acksen/SafewaterHardware/docs/installation_and_faults_overview/Aquaductor-Controller-Fascia-Overview-08.pdf

T2

# Aquaductor Ultraviolet Water Purification Controller

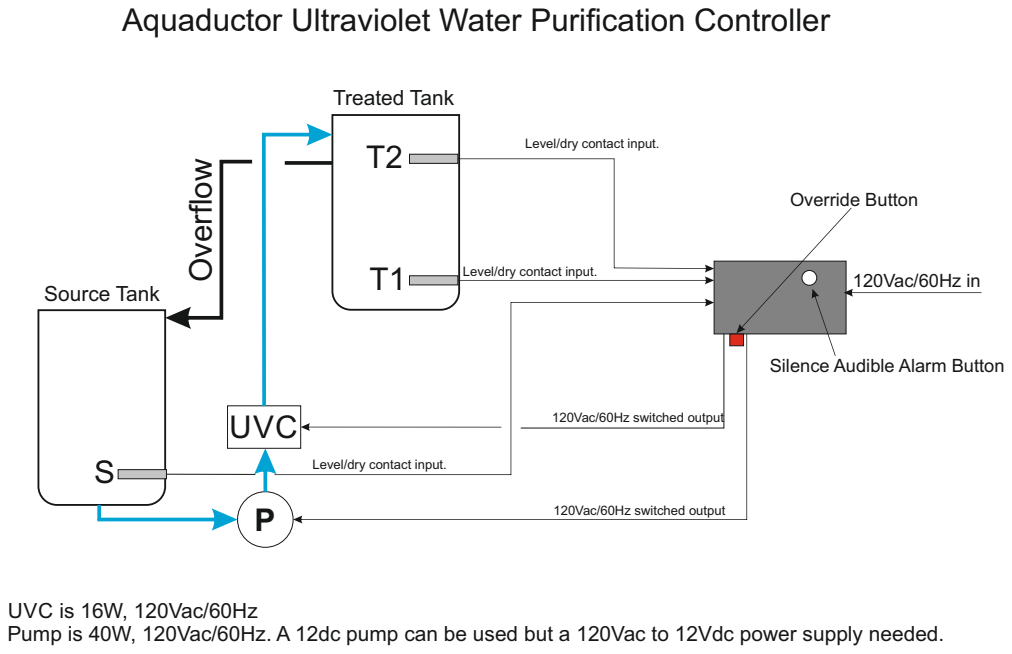
[picture p1: page 1]
UVC; Override Button; 120Vac/60Hz switched output; 120Vac/60Hz in; Source Tank; Treated Tank; Overflow

Level/dry contact input.

Silence Audible Alarm Button

UVC is 16W, 120Vac/60Hz
Pump is 40W, 120Vac/60Hz. A 12dc pump can be used but a 120Vac to 12Vdc power supply needed.

# Motor Pump Motor Pump

# This orientation may be permissible but why would you choose it?

# Recommended pump mounting

# Any leaks run off the pump and cause

minimal risk to the motor and wiring.

# Aquaductor Provisional Enclosure Layout (Scale 1:1 approx)

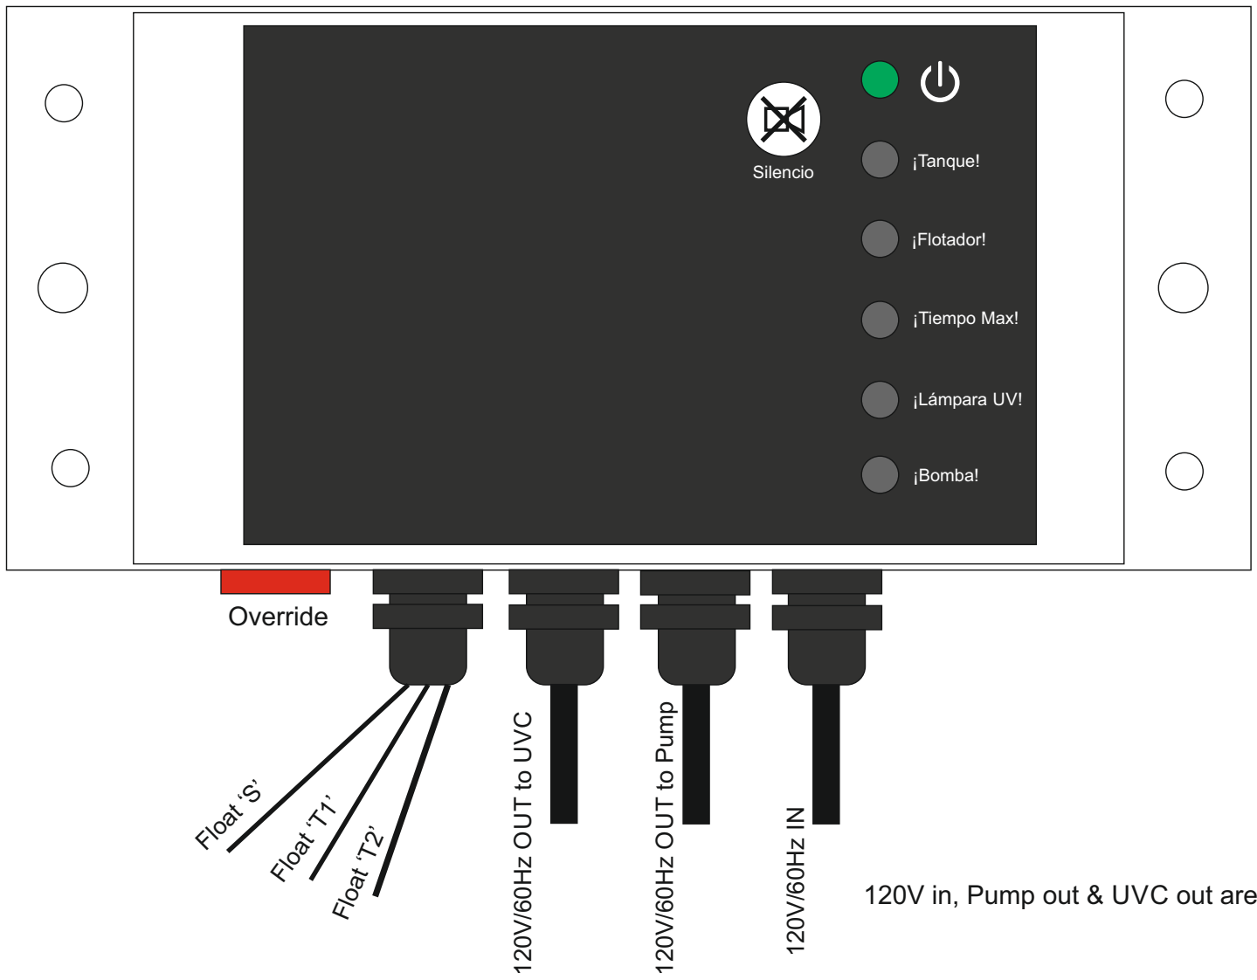
[picture p2: figure]
¡Lámpara UV!; ¡Bomba!; ¡Tiempo Max!; ¡Flotador!; ¡Tanque! Silencio120V/60Hz IN; 120V/60Hz OUT to UVC; 120V/60Hz OUT to Pump; Float ‘S’ Float ‘T1’; Float ‘T2’; Override

120V in, Pump out & UVC out are 1m length leads.

The bottom of this enclosure arrangement MUST be mounted above the highest part of the water circuit, all cables must have drip loops. No part of the water circuit must be mounted above this control enclosure.

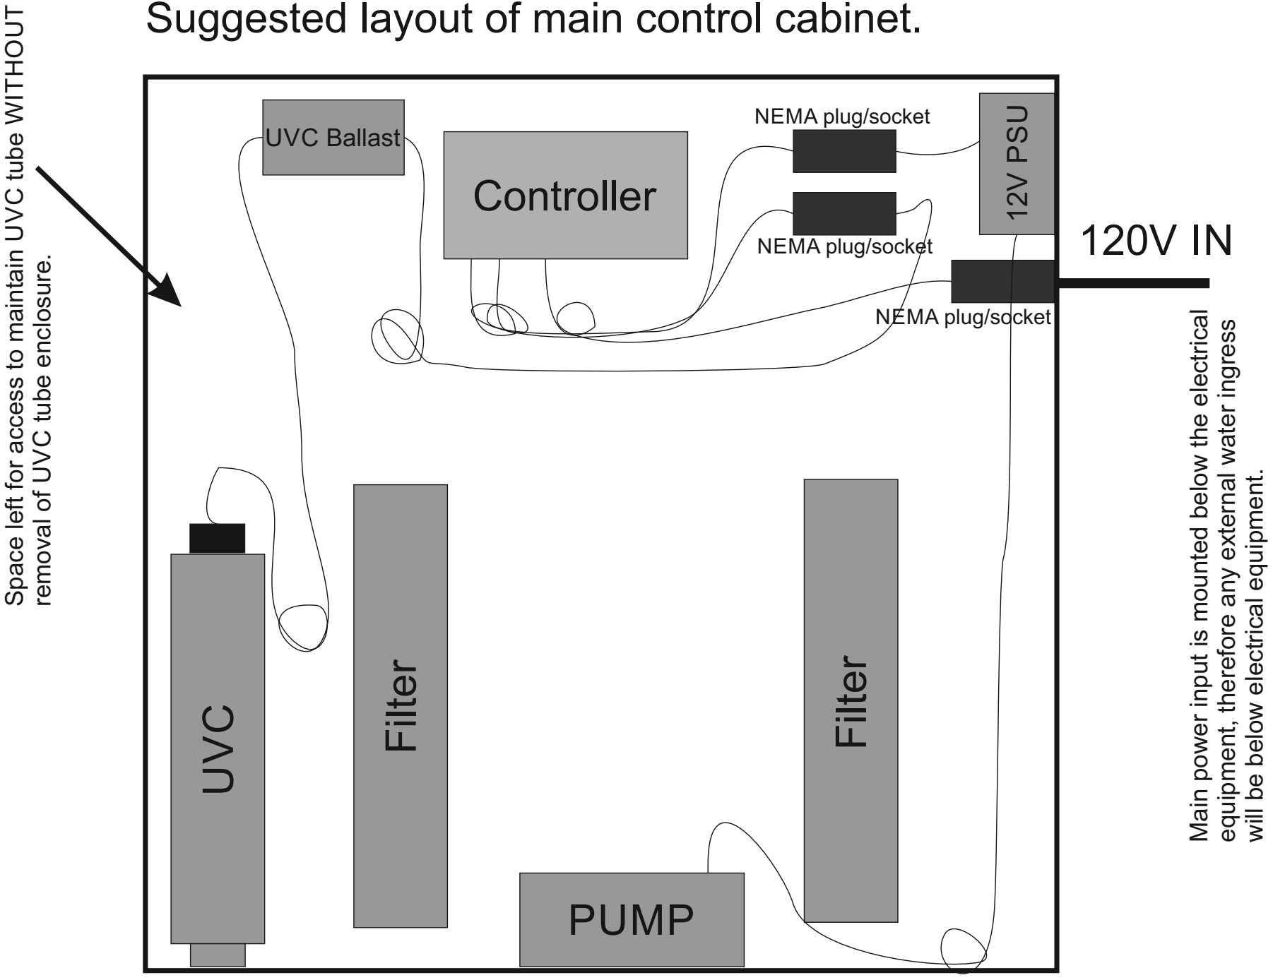
[picture p3: figure]
PUMP; Filter; Space left for access to maintain; C tube; WIT; removal of; C tube enclosure.; UVC Ballast; Controller; NEMA plug/socket; will be below electrical equipment.

Suggested layout of main control cabinet.

Main power input is mounted below the electrical
equipment, therefore any external water ingress

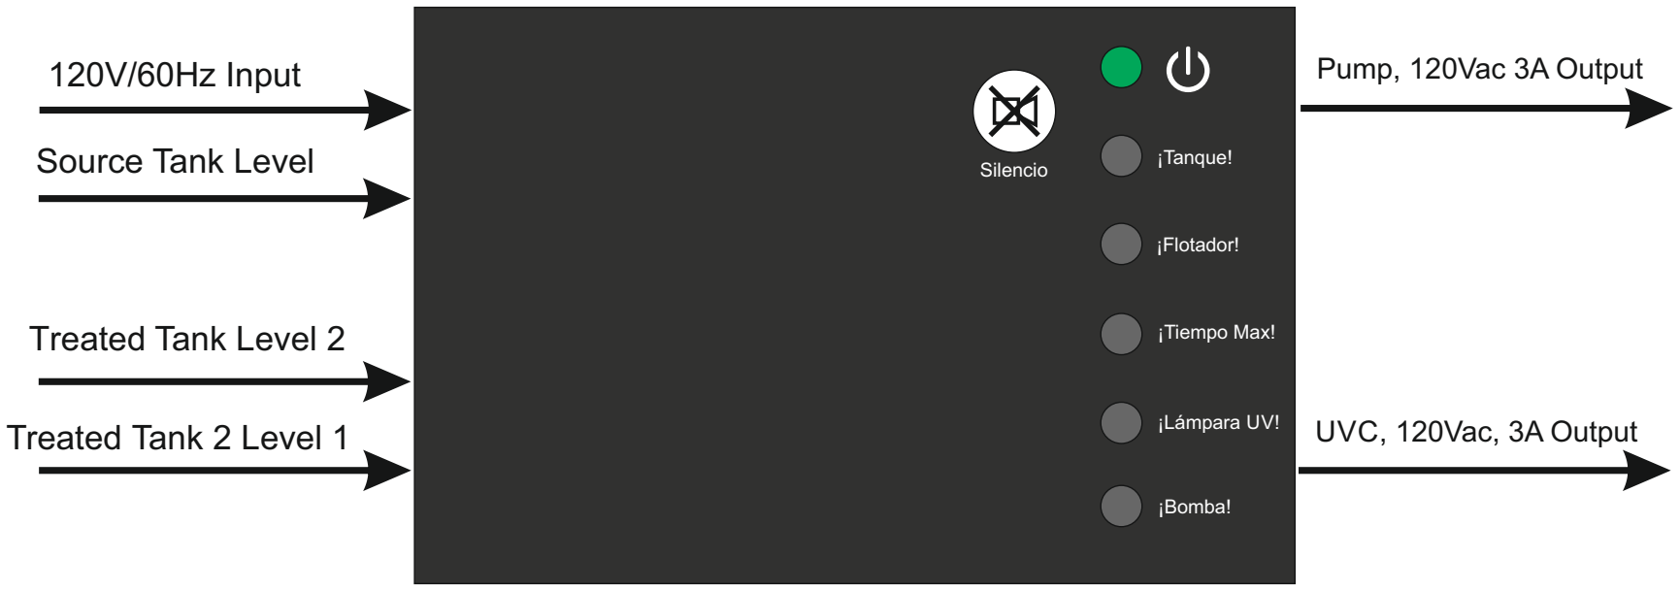
[picture p4: figure]
120V/60Hz Input; Treated Tank Level 2; Treated Tank 2 Level 1; Pump, 120Vac 3A Output; UVC, 120Vac, 3A Output; Source Tank Level; ¡Lámpara UV!; ¡Bomba!; ¡Tiempo Max!; ¡Flotador!; ¡Tanque! Silencio

Enclosure, ABS, wall mountable sealed to IP66 to IP68.
Mains input is hard-wired lead
Pump and UVC outputs are hard-wired via cable glands
Water level inputs are via connectors, which can be made on-site.
Level inputs are from dry contacts on level switches.

System monitors current to UVC lamp & pump and alarms if either is on but no current flowing. PCB has fuses on inputs and outputs.

# Aquaductor Ultraviolet Water Purification Controller

Normal (no alarms) running LED output status.

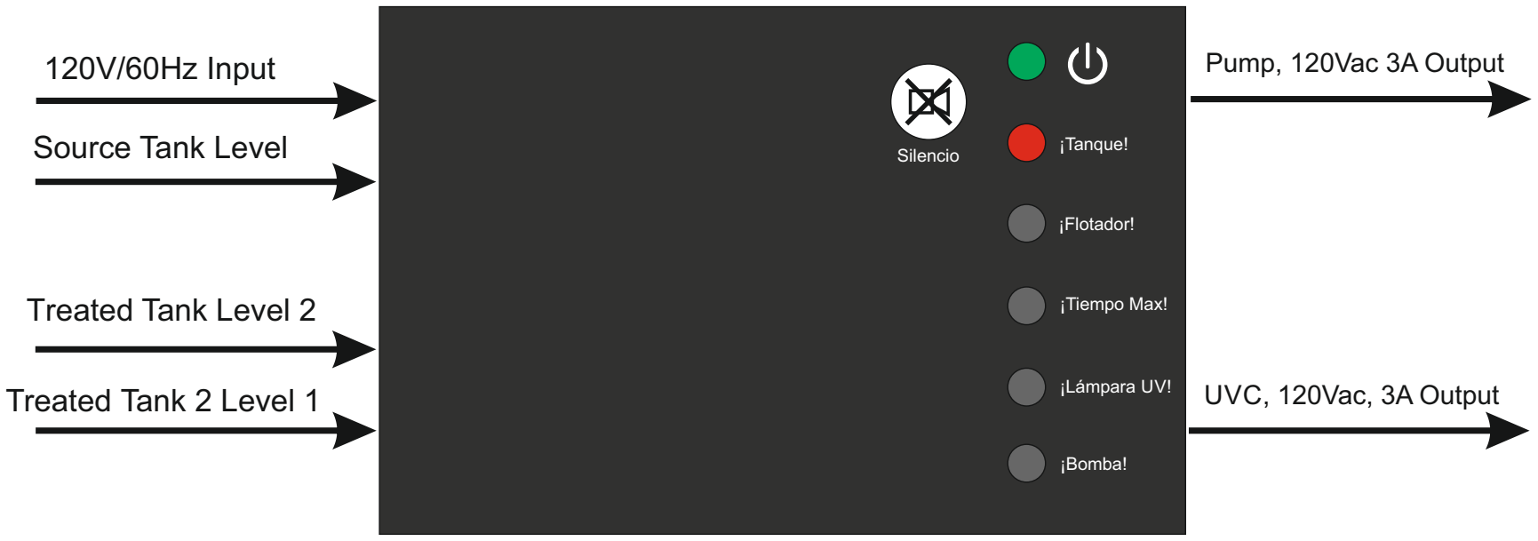
[picture p5: figure]
120V/60Hz Input; Treated Tank Level 2; Treated Tank 2 Level 1; Pump, 120Vac 3A Output; UVC, 120Vac, 3A Output; Source Tank Level; ¡Lámpara UV!; ¡Bomba!; ¡Tiempo Max!; ¡Flotador!; ¡Tanque! Silencio

Enclosure, ABS, wall mountable sealed to IP66 to IP68.
Mains input is hard-wired lead
Pump and UVC outputs are hard-wired via cable glands
Water level inputs are via connectors, which can be made on-site.
Level inputs are from dry contacts on level switches.

System monitors current to UVC lamp & pump and alarms if either is on but no current flowing. PCB has fuses on inputs and outputs.

# Aquaductor Ultraviolet Water Purification Controller

# Source Tank Empty Alarm

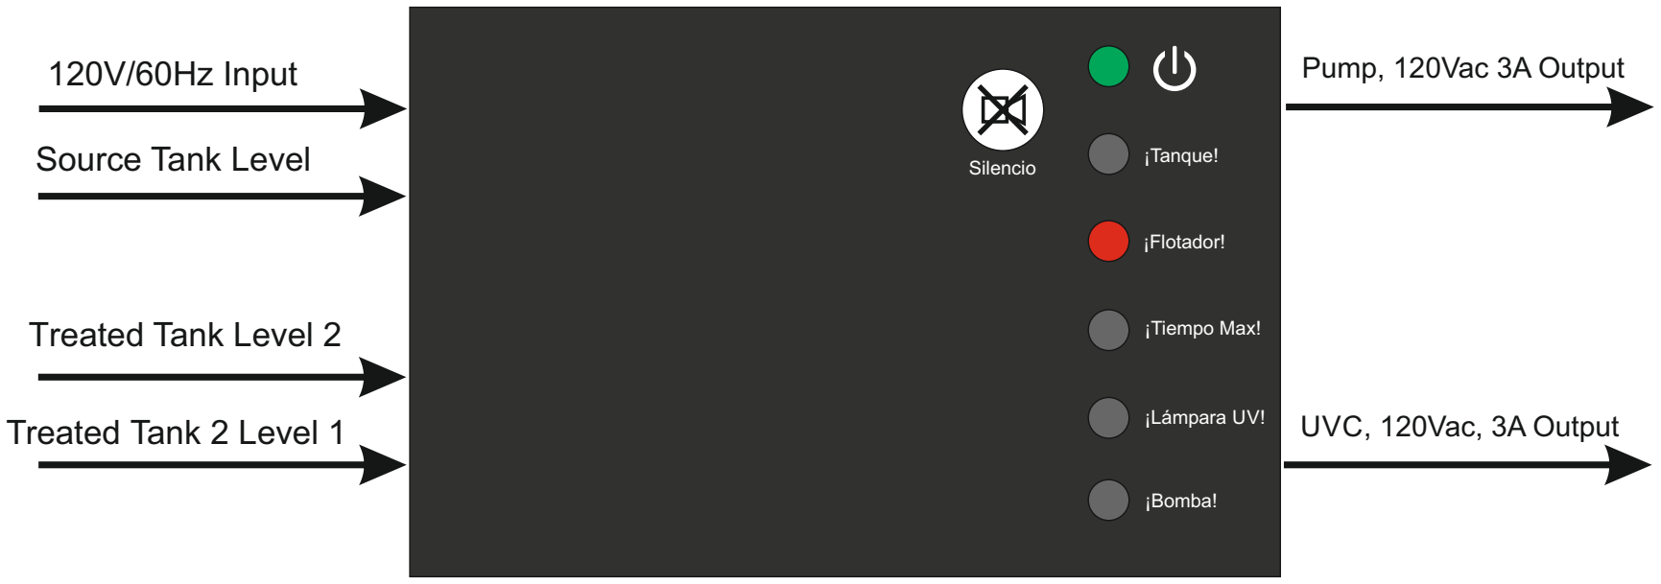
[picture p6: figure]
120V/60Hz Input; Treated Tank Level 2; Treated Tank 2 Level 1; Pump, 120Vac 3A Output; UVC, 120Vac, 3A Output; Source Tank Level; ¡Lámpara UV!; ¡Bomba!; ¡Tiempo Max!; ¡Flotador!; ¡Tanque! Silencio

Enclosure, ABS, wall mountable sealed to IP66 to IP68.
Mains input is hard-wired lead
Pump and UVC outputs are hard-wired via cable glands
Water level inputs are via connectors, which can be made on-site.
Level inputs are from dry contacts on level switches.

System monitors current to UVC lamp & pump and alarms if either is on but no current flowing. PCB has fuses on inputs and outputs.

# Aquaductor Ultraviolet Water Purification Controller

# Float Error Alarm

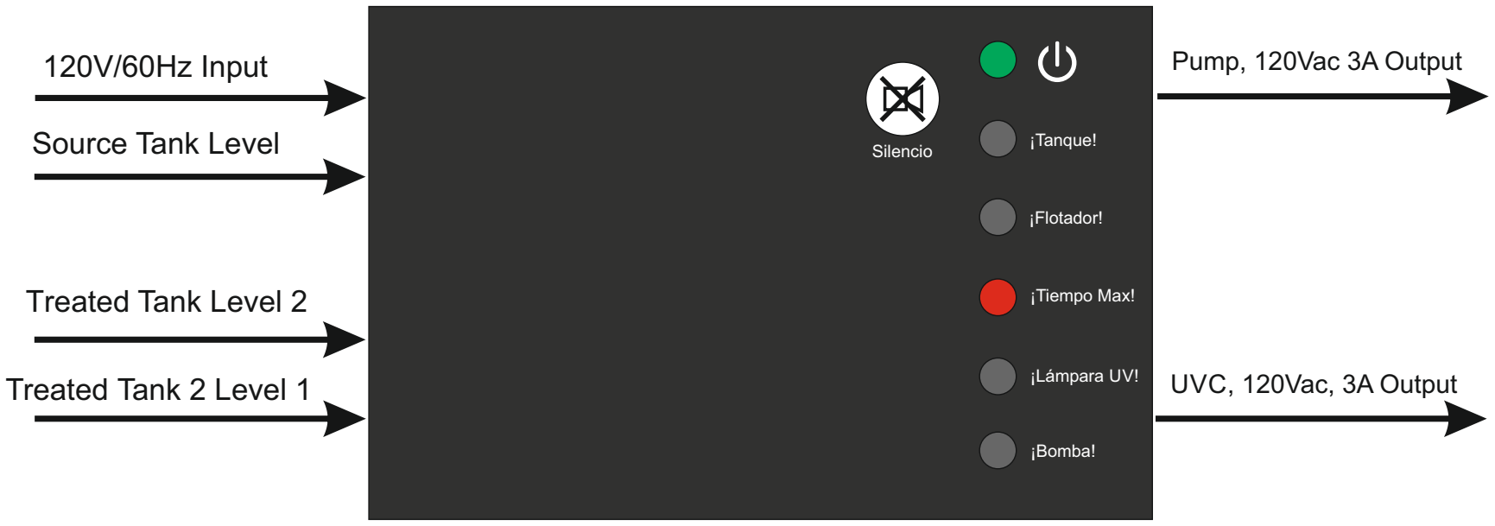
[picture p7: figure]
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

# Aquaductor Ultraviolet Water Purification Controller

# Maximum Runtime Exceeded Alarm

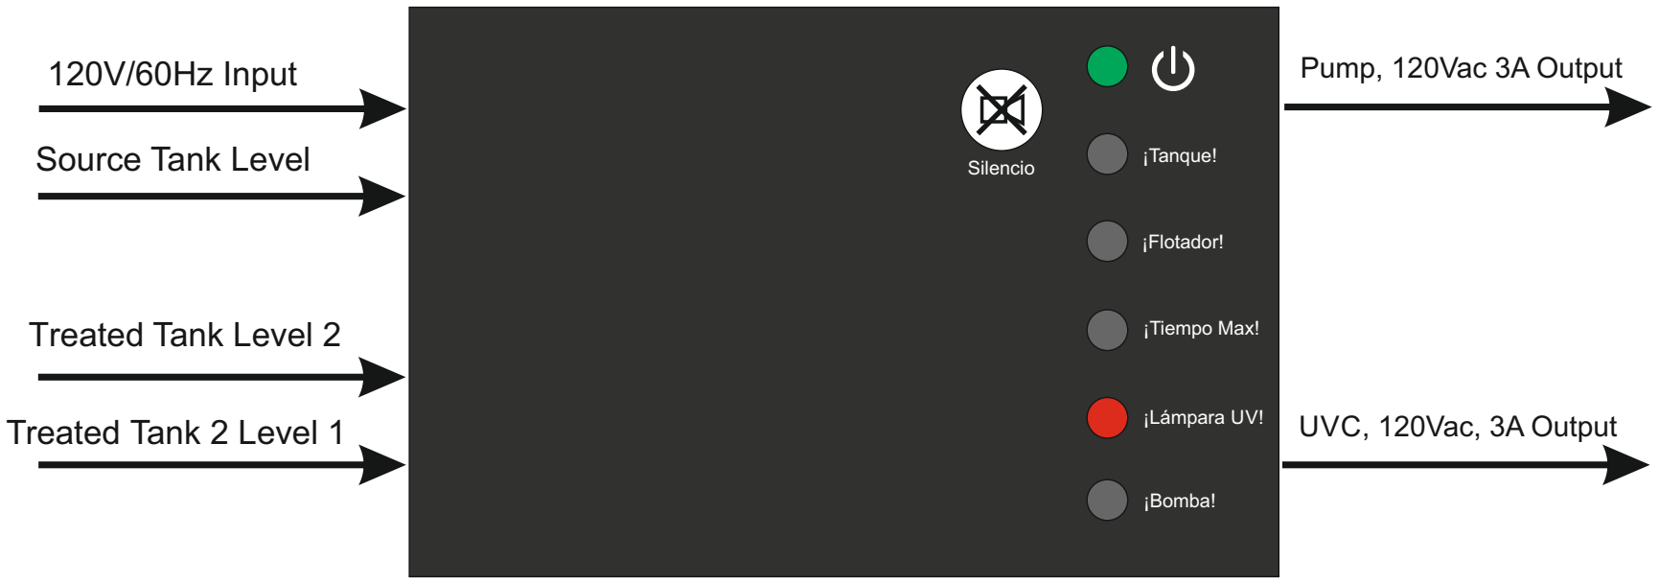
[picture p8: figure]
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

# Aquaductor Ultraviolet Water Purification Controller

# UVC Tube Fault Alarm

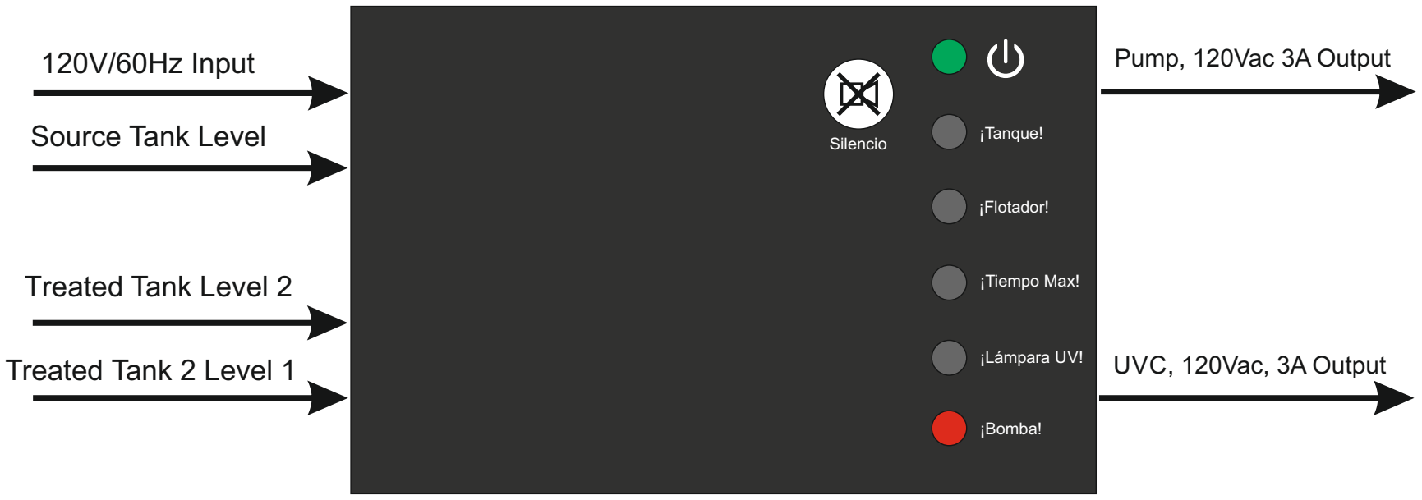
[picture p9: figure]
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

# Aquaductor Ultraviolet Water Purification Controller

# Pump Fault Alarm
