acksen/SafewaterHardware/docs/wiring_diagrams/english/Aquaductor Wiring-4-Wire-En-01.pdf

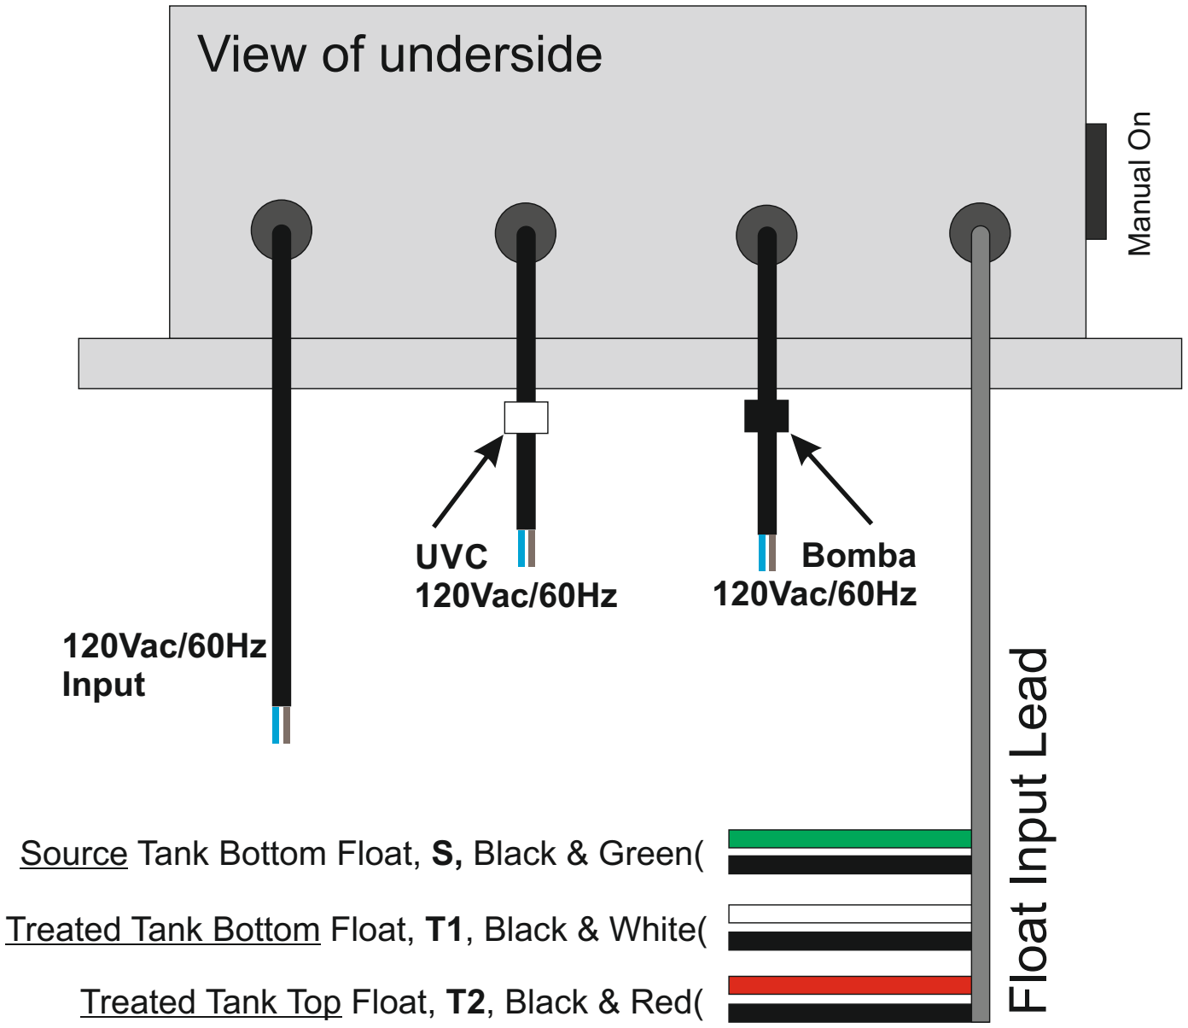
[picture p21: figure]
Bomba 120Vac/60Hz; Manual On; UVC 120Vac/60Hz; View of underside; 120Vac/60Hz Input

Source Tank Bottom Float, S, Black & Green(

Treated Tank Bottom Float, T1, Black & White(

Treated Tank Top Float, T2, Black & Red(

Float orientation and logic:-
For all floats, water high level must close contact. Therefore when water is low the contact is open.

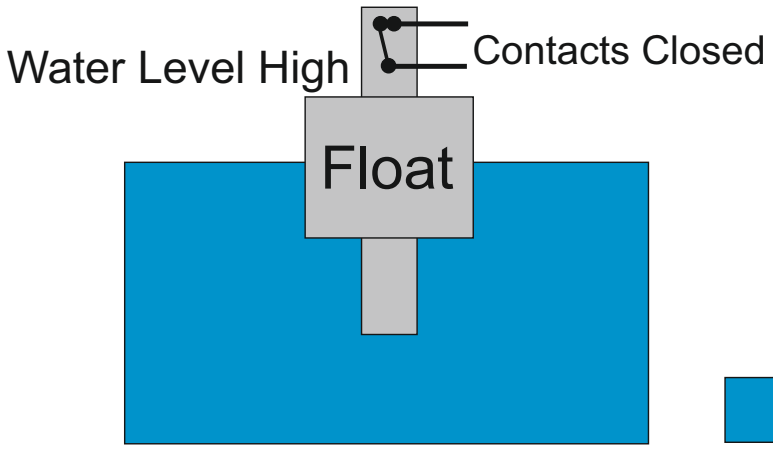
[picture p22: figure]
Water Level High; Contacts Closed; Float

Water Level Low

Contacts Open

## Float

## Aquaductor Controller Wiring (4-wire). Float Input Lead

Black lead is common to all 3 float inputs.

## Treated Tanque

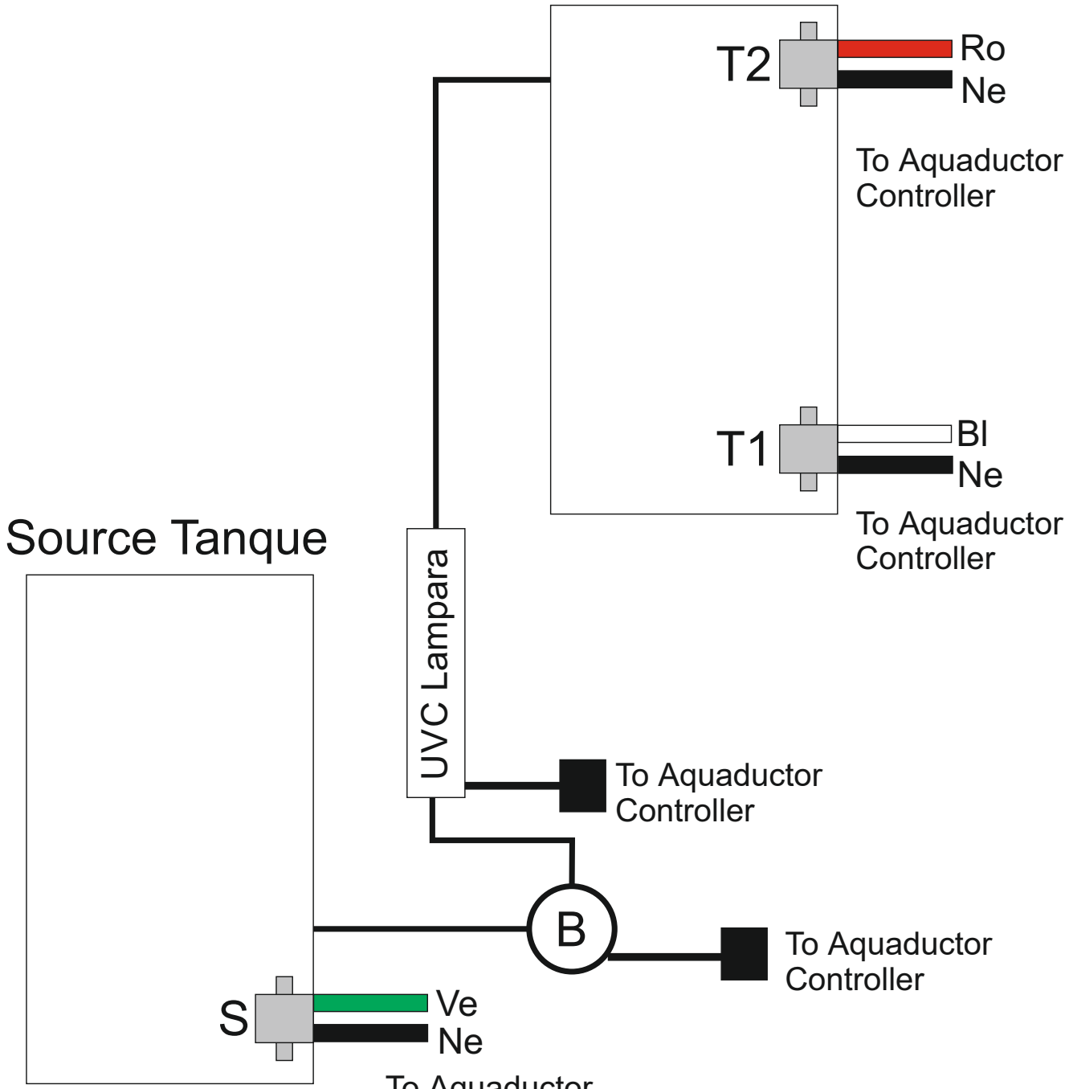
[picture p23: figure]
Source Tanque; UVC Lampara; Controller; To Aquaductor Controller

Ne

Ro

Ne

Bl

## To Aquaductor

## To Aquaductor

Controller
