acksen/SafewaterHardware/docs/wiring_diagrams/spanish/Aquaductor Wiring-4-Wire-ES-01.pdf

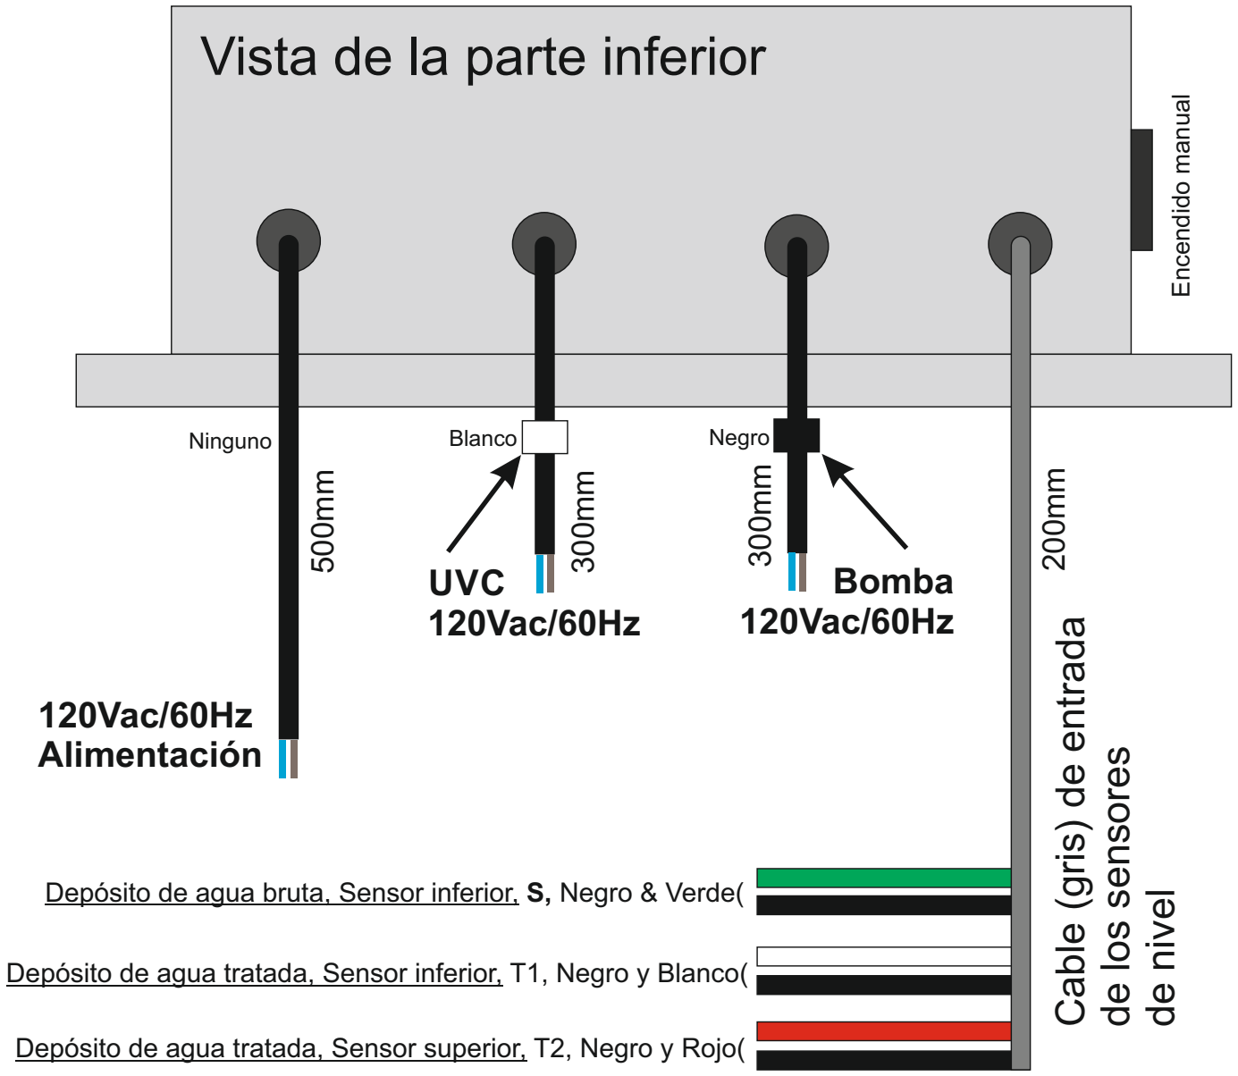
[picture p24: figure]
Bomba 120Vac/60Hz; Encendido manual; UVC 120Vac/60Hz; Vista de la parte inferior; 120Vac/60Hz Alimentación; Ninguno; Blanco; Negro 500mm

Depósito de agua bruta, Sensor inferior, S, Negro & Verde(

Depósito de agua tratada, Sensor inferior, T1, Negro y Blanco(

Depósito de agua tratada, Sensor superior, T2, Negro y Rojo(

Orientación y lógica del sensor de nivel:-
Para todos los sensores, nivel alto de agua contacto cerrado. Por lo tanto, cuando el nivel de agua es bajo el contacto está abierto.

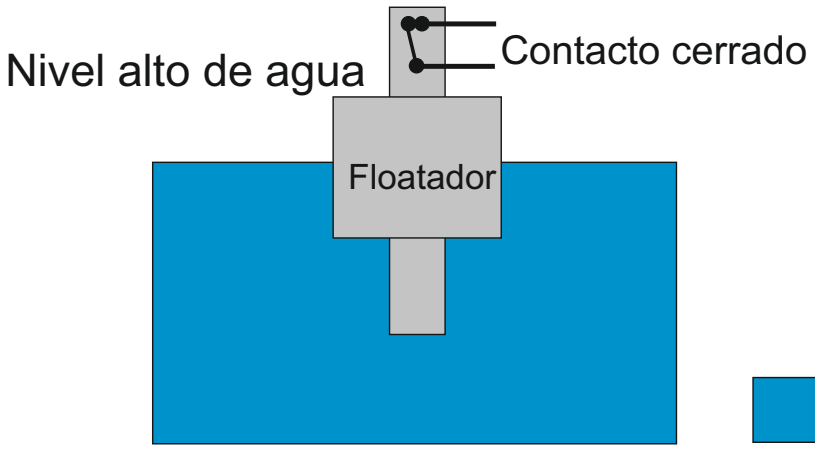
[picture p25: figure]
Nivel alto de agua; Contacto cerrado; Floatador

## Nivel de agua bajo

## Contacto abrierto

Floatador

Cableado del Controlador Aquaductor. (4-cables). Cable ⁽gris⁾ de entrada de los sensores de nivel

El cable negro es común para las tres entradas.

## Depósito de agua tratada

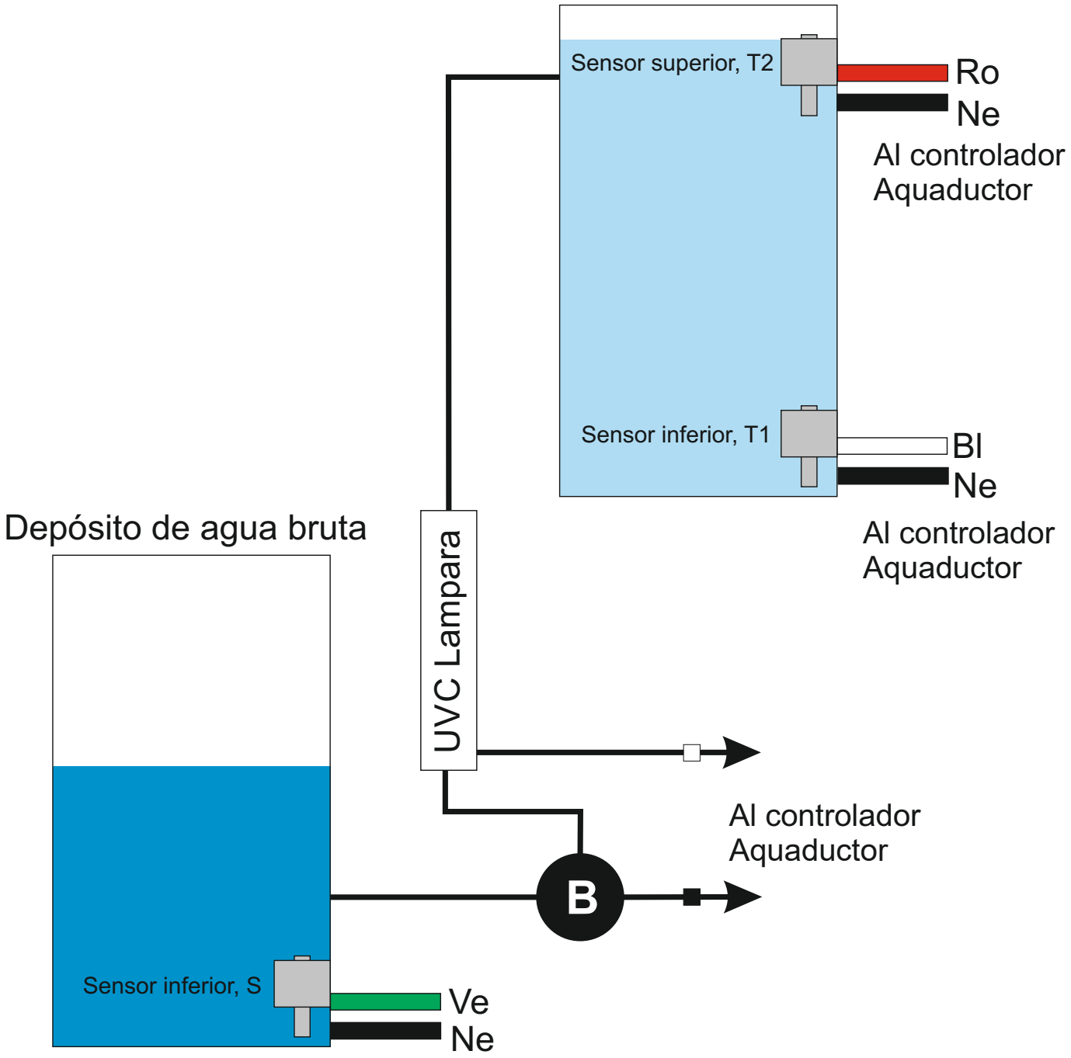
[picture p26: figure]
Depósito de agua bruta; UVC Lampara; Al controlador Aquaductor; Sensor inferior, S; Sensor inferior, T1; Sensor superior, T2

## Al controlador

# Aquaductor

Cableado del Controlador Aquaductor. (4-cables).
