acksen/SafewaterHardware/pcb/SafeWater-EVA169062-IGNORE PUMP AMPS-33 - Schematic.PDF

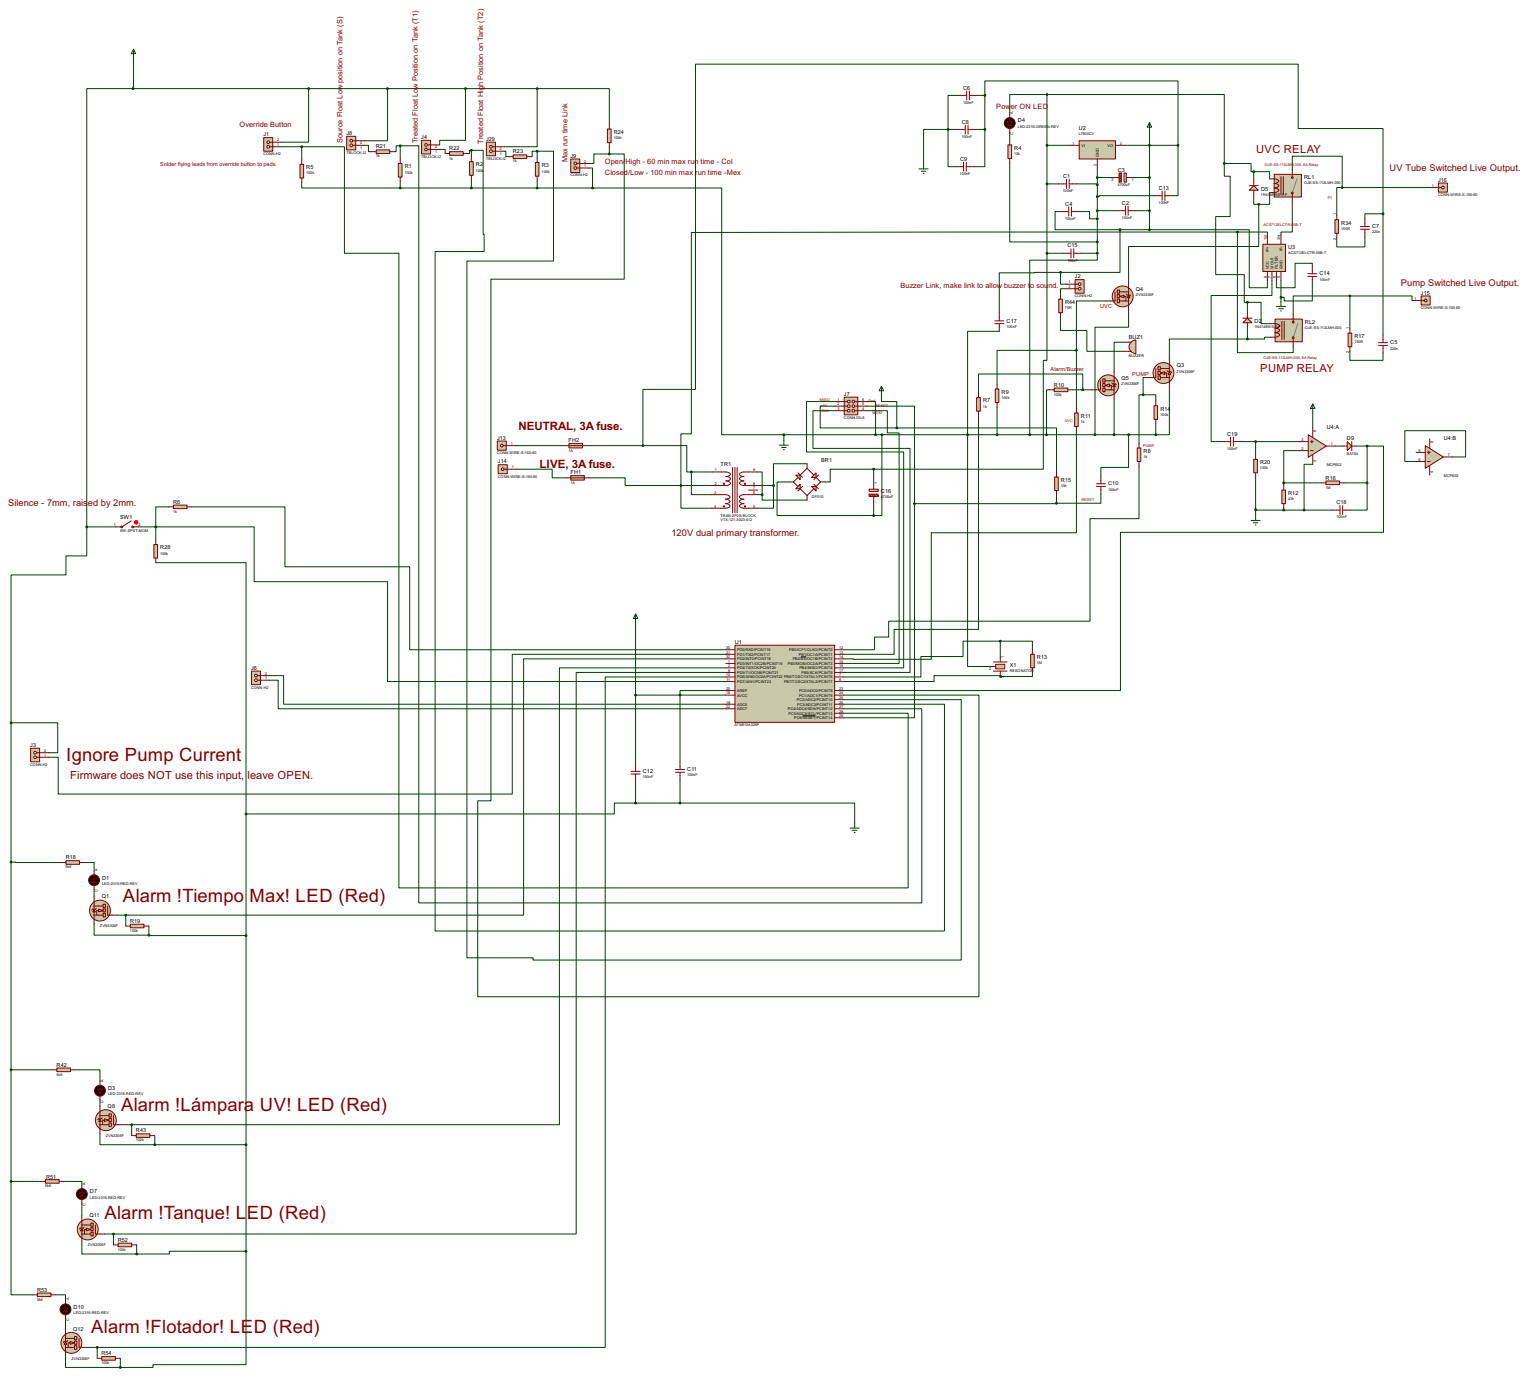
[picture p27: page 1]

Open/High - 60 min max run time - Col

Solder flying leads from override button to pads.

UV Tube Switched Live Output.

Buzzer Link, make link to allow buzzer to sound. | | 100nF

Pump Switched Live Output.

MOSI

CONN-DIL6

25 PC1/ADC1/PCINT9
26 PC2/ADC2/PCINT10

28 PC4/ADC4/SDA/PCINT12
29 PC5/ADC5/SCL/PCINT13

LED-2316-RED-REV

100k Alarm !Flotador! LED (Red)
