acksen/SafewaterHardware/pcb/SafeWater-EVA169062-IGNORE PUMP AMPS-33 - PCB Layout.PDF

S | T1 | T2
S | T1 | T2

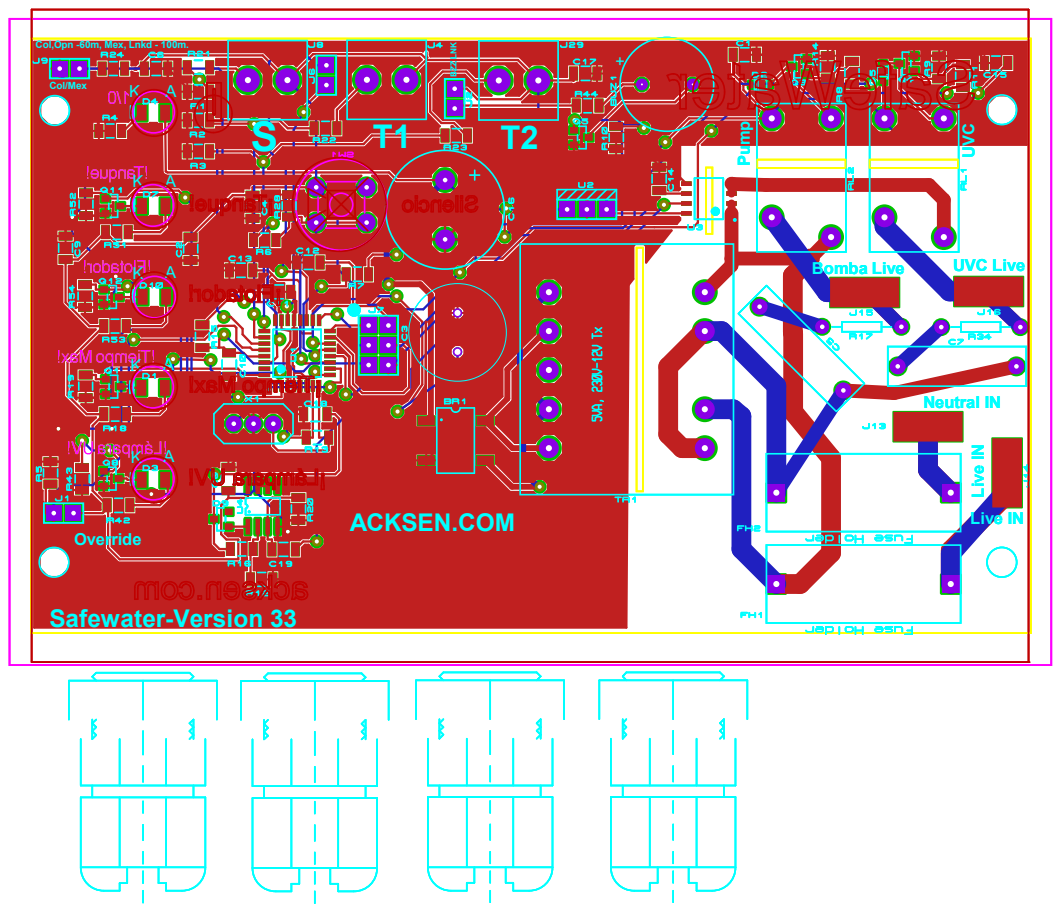
[picture p28: page 1]
Bomba Live; UVC Live; Live IN; Safewater-Version 33; Override; BZZ LNK; Col/Mex; ACKSEN.COM; UVC Pump

Col,Opn -60m, Mex, Lnkd - 100m.

Neutral INLive IN
