acksen/SafewaterHardware/(list of files, drawings)

Other design files:
pcb/SafeWater-EVA169062-IGNORE PUMP AMPS-33.pdsprj
